wuehr1999/JECCbotMower/hardware/controlpcb/rendering.png

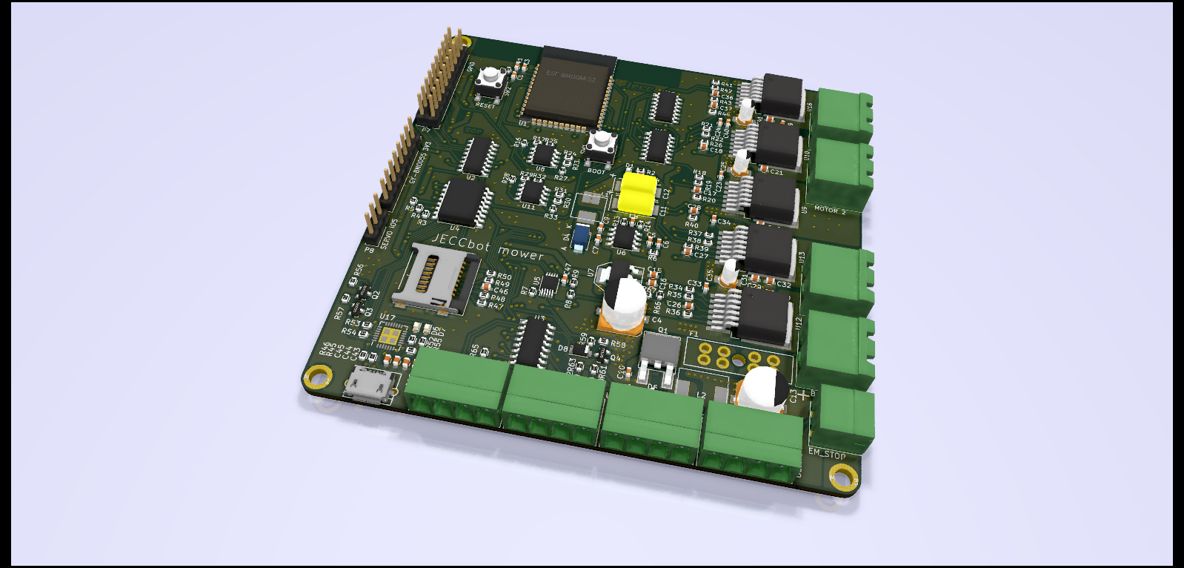
hardware/controlpcb/rendering.png
