wuehr1999/JECCbotMower/README.md

# JECCbotMower

Implementation of JECCbot modifications for lawn mowing robot
