wuehr1999/JECCbotMower/hardware/controlpcb/kicad-source/JECCbotESP32.kicad_pcb

## KiCad design hardware/controlpcb/kicad-source/JECCbotESP32.kicad_pcb (2020-06-06)

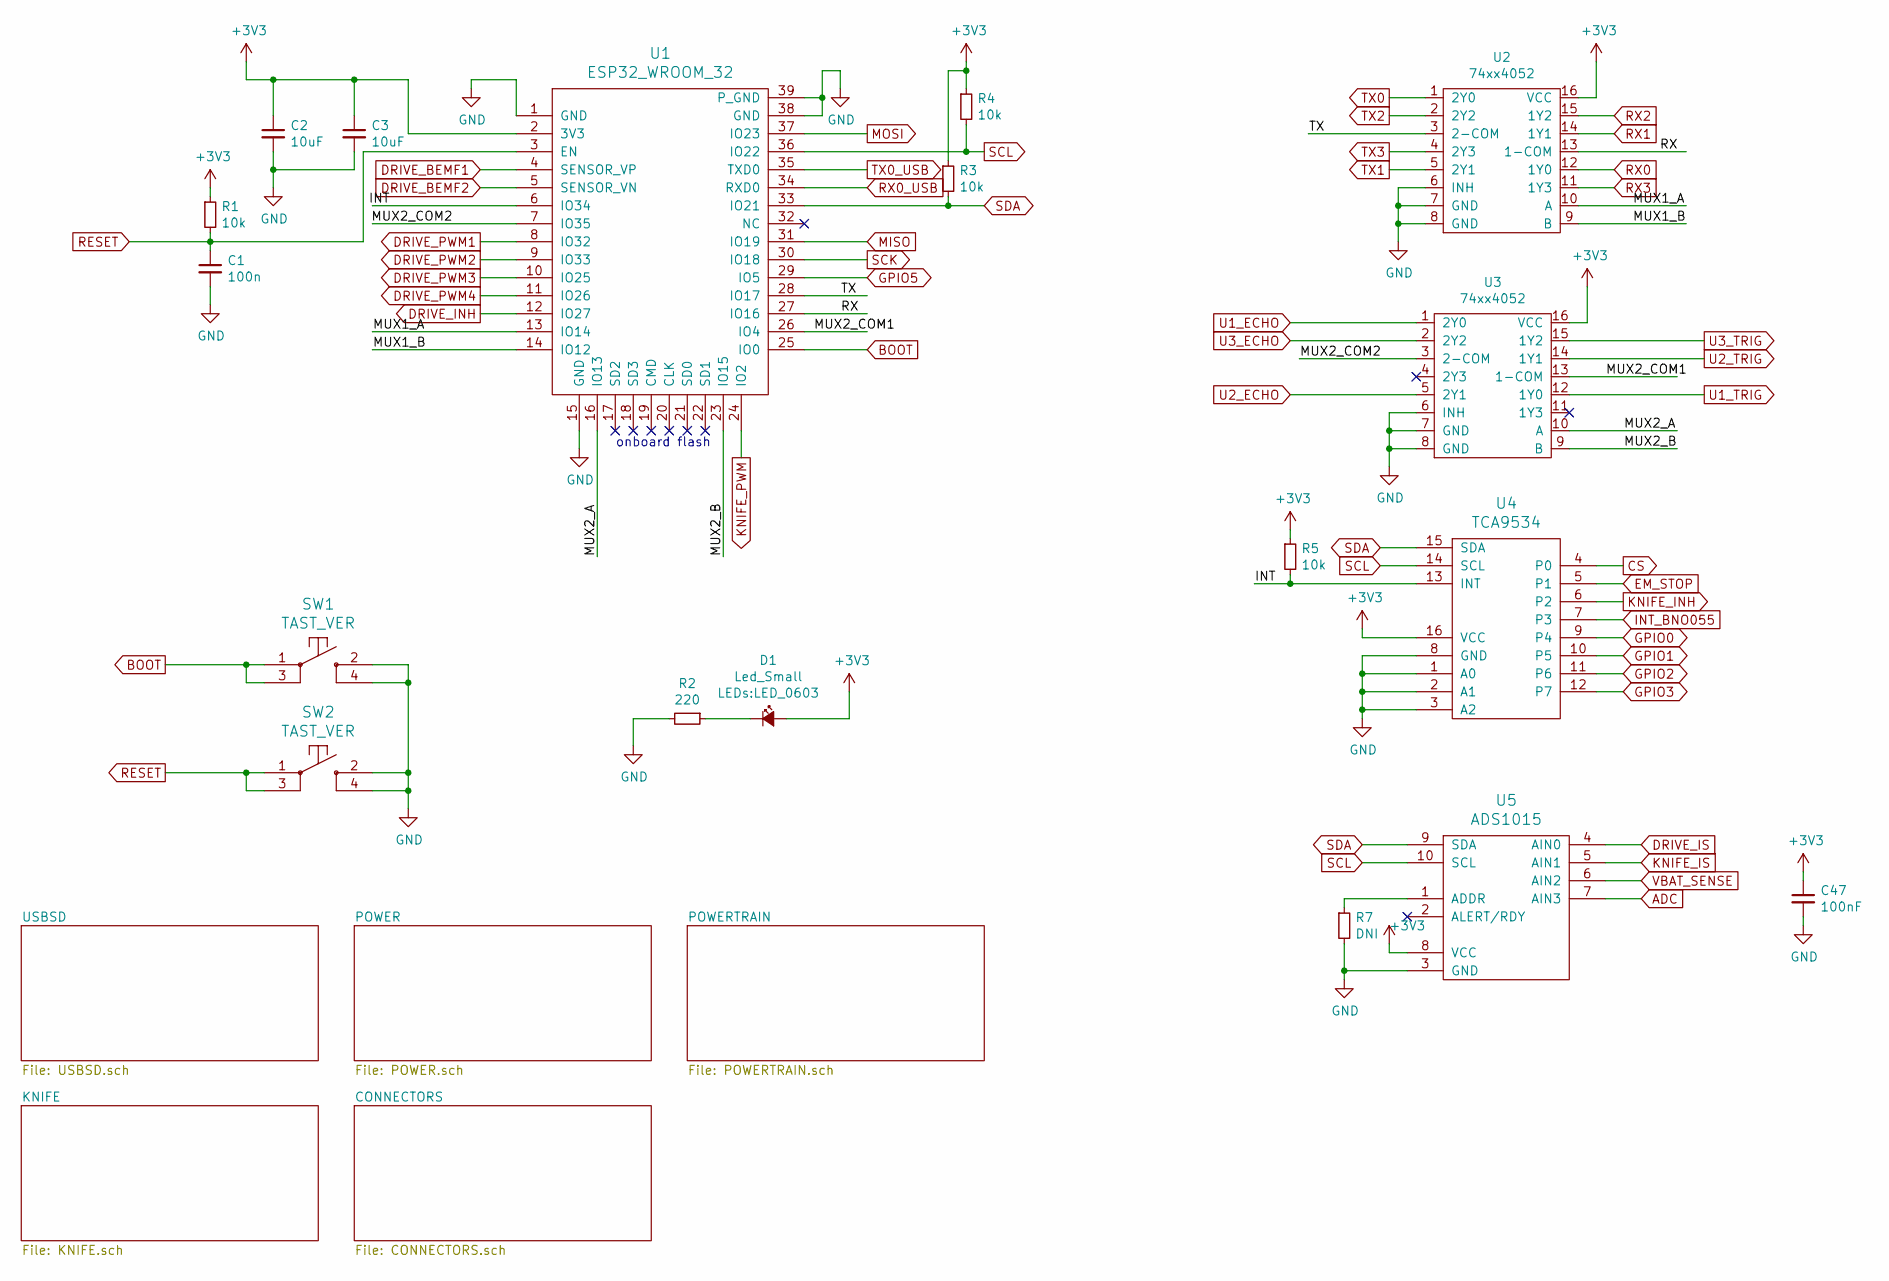
[picture p8: schematic JECCbotESP32.sch, JECCbot Mower PCB ESP32]

Parts:
C1: 100n; C_0603
C2, C3: 10uF; C_0603
C47: 100nF; C_0603
D1: Led_Small; LED_0603
R1, R3, R4, R5: 10k; R_0603
R2: 220; R_0603
R7: DNI; R_0603
SW1, SW2: TAST_VER; WE_430182050816
U1: ESP32_WROOM_32; ESP32-WROOM-32
U2, U3: 74xx4052; SOIC-16_3.9x9.9mm_Pitch1.27mm
U4: TCA9534; SOIC-16_7.5x10.3mm_Pitch1.27mm
U5: ADS1015; MSOP-10_3x3mm_Pitch0.5mm

Connections:
+3V3: C2.1, C3.1, C47.1, D1.2 (A), R1.1, R3.1, R4.1, R5.1, U1.2 (3V3), U2.16 (VCC), U3.16 (VCC), U4.16 (VCC), U5.8 (VCC); also elsewhere on the board
/INT: R5.2, U1.6 (IO34), U4.13 (INT)
/MUX1_A: U1.13 (IO14), U2.10 (A)
/MUX1_B: U1.14 (IO12), U2.9 (B)
/MUX2_A: U1.16 (IO13), U3.10 (A)
/MUX2_B: U1.23 (IO15), U3.9 (B)
/MUX2_COM1: U1.26 (IO4), U3.13 (1-COM)
/MUX2_COM2: U1.7 (IO35), U3.3 (2-COM)
/RX: U1.27 (IO16), U2.13 (1-COM)
/TX: U1.28 (IO17), U2.3 (2-COM)
ADC: U5.7 (AIN3); also elsewhere on the board
BOOT: SW1.1, SW1.3, U1.25 (IO0); also elsewhere on the board
CS: U4.4 (P0); also elsewhere on the board
DRIVE_BEMF1: U1.4 (SENSOR_VP); also elsewhere on the board
DRIVE_BEMF2: U1.5 (SENSOR_VN); also elsewhere on the board
DRIVE_INH: U1.12 (IO27); also elsewhere on the board
DRIVE_IS: U5.4 (AIN0); also elsewhere on the board
DRIVE_PWM1: U1.8 (IO32); also elsewhere on the board
DRIVE_PWM2: U1.9 (IO33); also elsewhere on the board
DRIVE_PWM3: U1.10 (IO25); also elsewhere on the board
DRIVE_PWM4: U1.11 (IO26); also elsewhere on the board
EM_STOP: U4.5 (P1); also elsewhere on the board
GND: C1.2, C2.2, C3.2, C47.2, R2.2, R7.2, SW1.2, SW1.4, SW2.2, SW2.4, U1.1 (GND), U1.15 (GND), U1.38 (GND), U1.39 (P_GND), U2.6 (INH), U2.7 (GND), U2.8 (GND), U3.6 (INH), U3.7 (GND), U3.8 (GND), U4.1 (A0), U4.2 (A1), U4.3 (A2), U4.8 (GND), U5.3 (GND); also elsewhere on the board
GPIO0: U4.9 (P4); also elsewhere on the board
GPIO1: U4.10 (P5); also elsewhere on the board
GPIO2: U4.11 (P6); also elsewhere on the board
GPIO3: U4.12 (P7); also elsewhere on the board
GPIO5: U1.29 (IO5); also elsewhere on the board
INT_BNO055: U4.7 (P3); also elsewhere on the board
KNIFE_INH: U4.6 (P2); also elsewhere on the board
KNIFE_IS: U5.5 (AIN1); also elsewhere on the board
KNIFE_PWM: U1.24 (IO2); also elsewhere on the board
MISO: U1.31 (IO19); also elsewhere on the board
MOSI: U1.37 (IO23); also elsewhere on the board
unnamed: D1.1 (K), R2.1
unnamed: R7.1, U5.1 (ADDR)
RESET: C1.1, R1.2, SW2.1, SW2.3, U1.3 (EN); also elsewhere on the board
RX0: U2.12 (1Y0); also elsewhere on the board
RX0_USB: U1.34 (RXD0); also elsewhere on the board
RX1: U2.14 (1Y1); also elsewhere on the board
RX2: U2.15 (1Y2); also elsewhere on the board
RX3: U2.11 (1Y3); also elsewhere on the board
SCK: U1.30 (IO18); also elsewhere on the board
SCL: R4.2, U1.36 (IO22), U4.14 (SCL), U5.10 (SCL); also elsewhere on the board
SDA: R3.2, U1.33 (IO21), U4.15 (SDA), U5.9 (SDA); also elsewhere on the board
TX0: U2.1 (2Y0); also elsewhere on the board
TX0_USB: U1.35 (TXD0); also elsewhere on the board
TX1: U2.5 (2Y1); also elsewhere on the board
TX2: U2.2 (2Y2); also elsewhere on the board
TX3: U2.4 (2Y3); also elsewhere on the board
U1_ECHO: U3.1 (2Y0); also elsewhere on the board
U1_TRIG: U3.12 (1Y0); also elsewhere on the board
U2_ECHO: U3.5 (2Y1); also elsewhere on the board
U2_TRIG: U3.14 (1Y1); also elsewhere on the board
U3_ECHO: U3.2 (2Y2); also elsewhere on the board
U3_TRIG: U3.15 (1Y2); also elsewhere on the board
VBAT_SENSE: U5.6 (AIN2); also elsewhere on the board

Notes on the sheet:
onboard flash

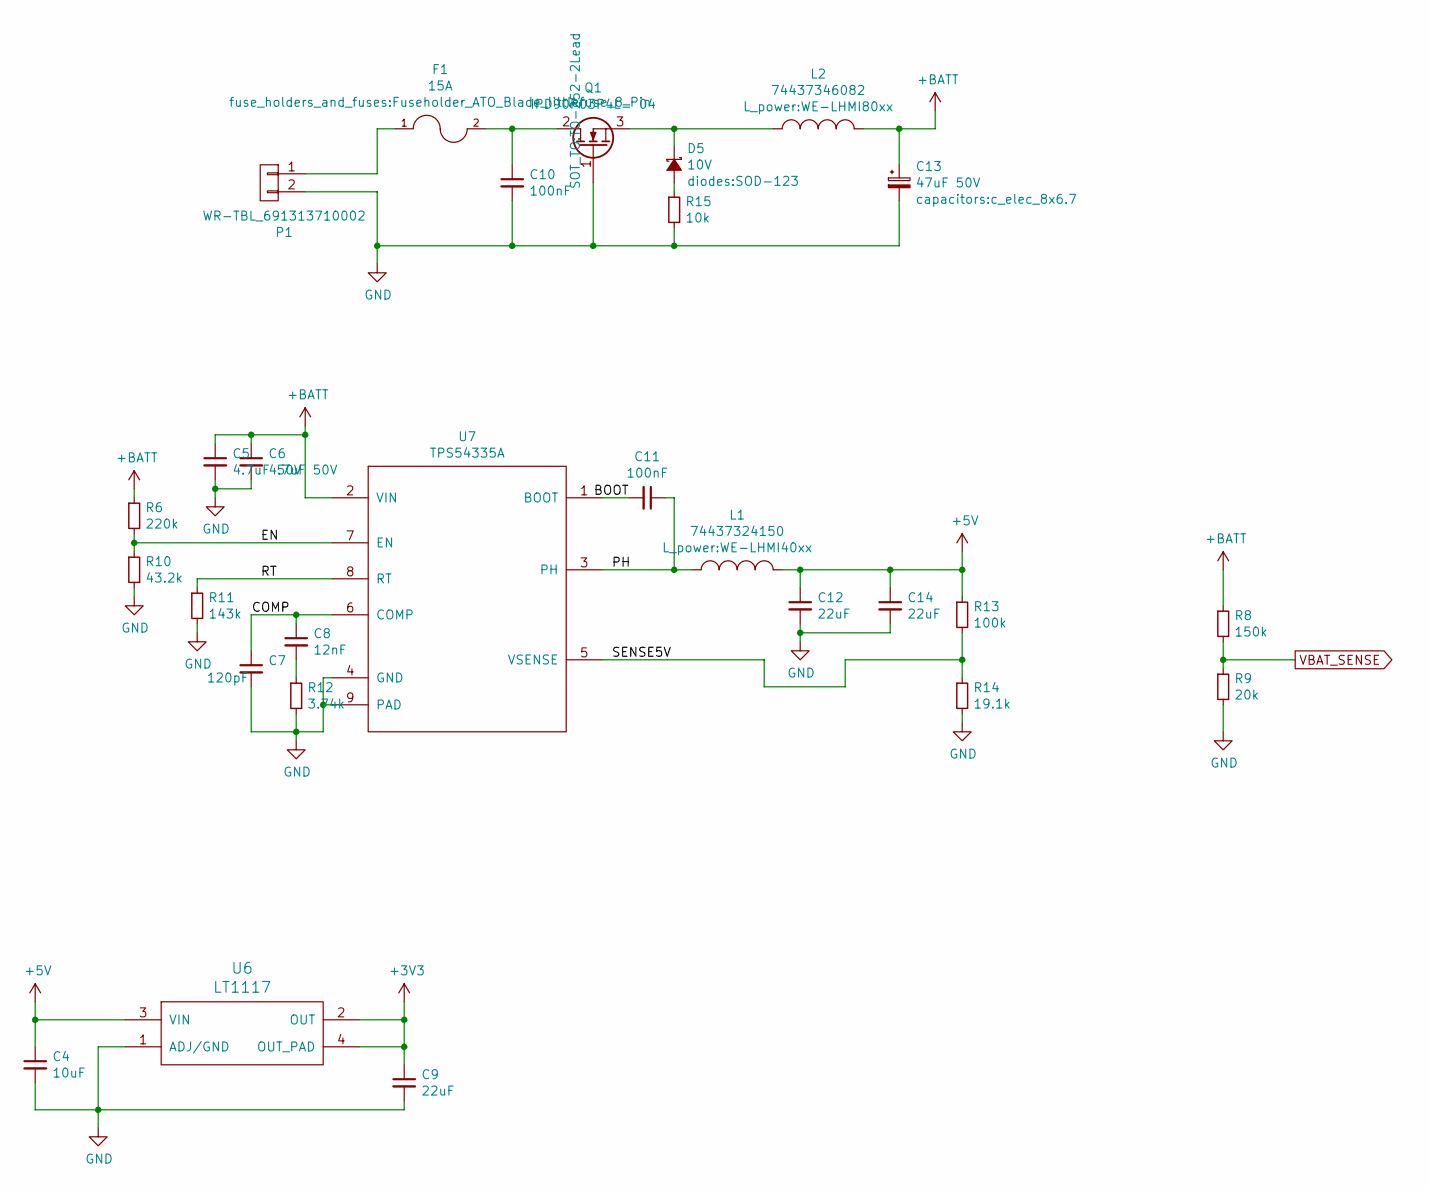
[picture p9: schematic POWER.sch, JECCbot Mower PCB ESP32]

Parts:
C4: 10uF; C_1206
C5, C6: 4.7uF 50V; C_1206
C7: 120pF; C_0603
C8: 12nF; C_0603
C9, C12, C14: 22uF; C_1206
C10, C11: 100nF; C_0603
C13: 47uF 50V; c_elec_8x6.7
D5: 10V; SOD-123
F1: 15A; Fuseholder_ATO_Blade_littlefuse_8_Pin
L1: 74437324150; WE-LHMI40xx
L2: 74437346082; WE-LHMI80xx
P1: WR-TBL_691313710002
Q1: IPD90P03P4L- 04; TO-252-2Lead
R6: 220k; R_0603
R8: 150k; R_0603
R9: 20k; R_0603
R10: 43.2k; R_0603
R11: 143k; R_0603
R12: 3.74k; R_0603
R13: 100k; R_0603
R14: 19.1k; R_0603
R15: 10k; R_0603
U6: LT1117; SOT-223
U7: TPS54335A; SOIC-8-1EP_3.9x4.9mm_Pitch1.27mm

Connections:
+3V3: C9.1, U6.2 (OUT), U6.4 (OUT_PAD); also elsewhere on the board
+5V: C4.1, C12.1, C14.1, L1.2, R13.1, U6.3 (VIN); also elsewhere on the board
+BATT: C5.1, C6.1, C13.1, L2.2, R6.1, R8.1, U7.2 (VIN); also elsewhere on the board
/POWER/COMP: C7.1, C8.1, U7.6 (COMP)
/POWER/EN: R6.2, R10.1, U7.7 (EN)
/POWER/PH: C11.1, L1.1, U7.3 (PH)
/POWER/RT: R11.1, U7.8 (RT)
/POWER/SENSE5V: R13.2, R14.1, U7.5 (VSENSE)
GND: C4.2, C5.2, C6.2, C7.2, C9.2, C10.2, C12.2, C13.2, C14.2, P1.2, Q1.1 (G), R9.2, R10.2, R11.2, R12.2, R14.2, R15.2, U6.1 (ADJ/GND), U7.4 (GND), U7.9 (PAD); also elsewhere on the board
unnamed: C8.2, R12.1
unnamed: C10.1, F1.2, Q1.2 (D)
unnamed: C11.2, U7.1 (BOOT)
unnamed: D5.1 (K), L2.1, Q1.3 (S)
unnamed: D5.2 (A), R15.1
unnamed: F1.1, P1.1
VBAT_SENSE: R8.2, R9.1; also elsewhere on the board

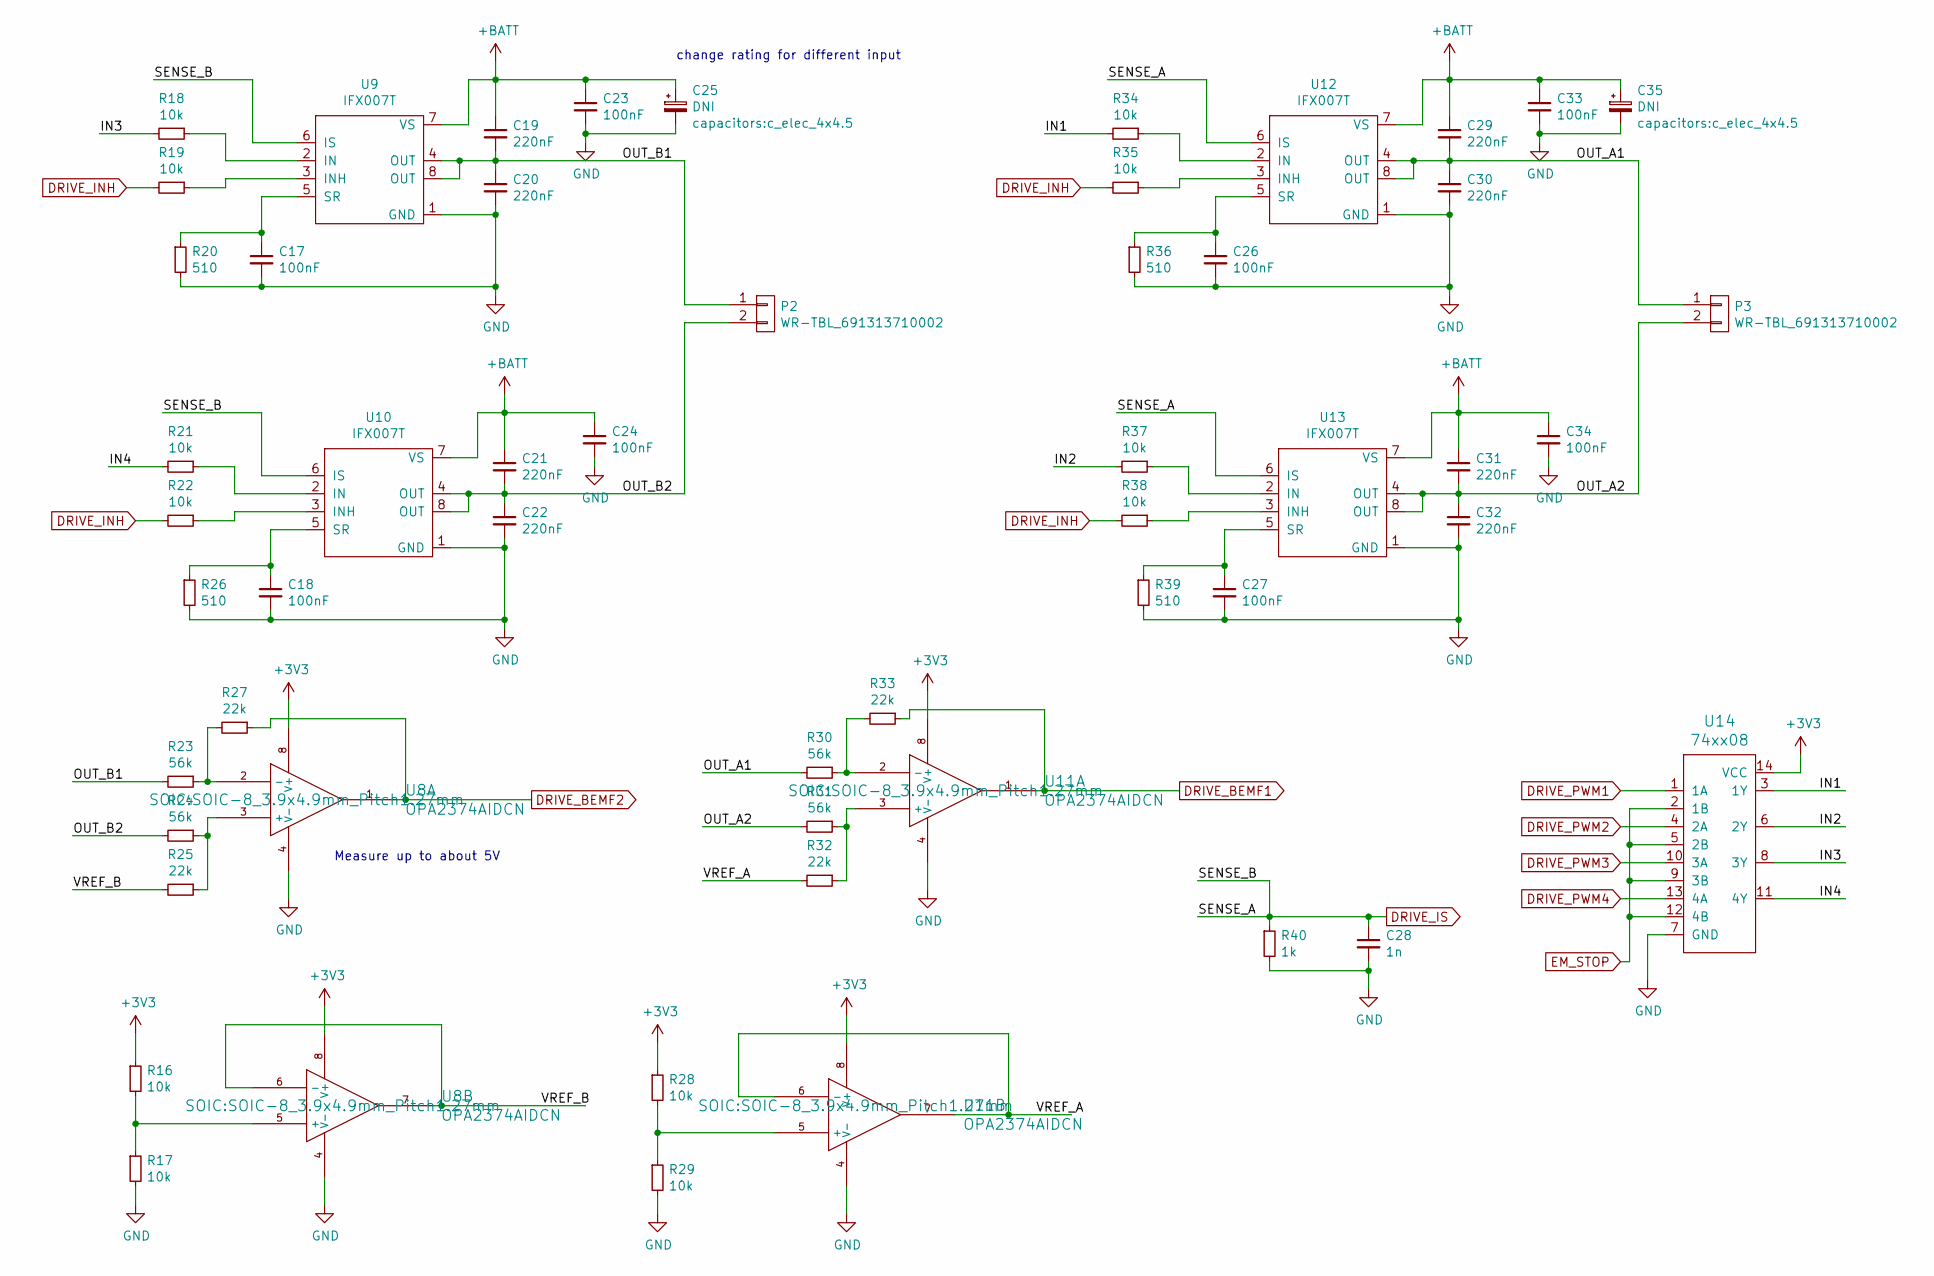
[picture p10: schematic POWERTRAIN.sch, JECCbot Mower PCB ESP32]

Parts:
C17, C18, C23, C24, C26, C27, C33, C34: 100nF; C_0603
C19, C20, C21, C22, C29, C30, C31, C32: 220nF; C_0603
C25, C35: DNI; c_elec_4x4.5
C28: 1n; C_0603
P2, P3: WR-TBL_691313710002
R16, R17, R18, R19, R21, R22, R28, R29, R34, R35, R37, R38: 10k; R_0603
R20, R26, R36, R39: 510; R_0603
R23, R24, R30, R31: 56k; R_0603
R25, R27, R32, R33: 22k; R_0603
R40: 1k; R_0603
U8, U11: OPA2374AIDCN; SOIC-8_3.9x4.9mm_Pitch1.27mm
U9, U10, U12, U13: IFX007T; TO-263-7Lead
U14: 74xx08; SOIC-14_3.9x8.7mm_Pitch1.27mm

Connections:
+3V3: R16.1, R28.1, U8.8 (V+), U11.8 (V+), U14.14 (VCC); also elsewhere on the board
+BATT: C19.1, C21.1, C23.1, C24.1, C25.1, C29.1, C31.1, C33.1, C34.1, C35.1, U9.7 (VS), U10.7 (VS), U12.7 (VS), U13.7 (VS); also elsewhere on the board
/POWERTRAIN/IN1: R34.2, U14.3 (1Y)
/POWERTRAIN/IN2: R37.2, U14.6 (2Y)
/POWERTRAIN/IN3: R18.2, U14.8 (3Y)
/POWERTRAIN/IN4: R21.2, U14.11 (4Y)
/POWERTRAIN/OUT_A1: C29.2, C30.1, P3.1, R30.2, U12.4 (OUT), U12.8 (OUT)
/POWERTRAIN/OUT_A2: C31.2, C32.1, P3.2, R31.2, U13.4 (OUT), U13.8 (OUT)
/POWERTRAIN/OUT_B1: C19.2, C20.1, P2.1, R23.2, U9.4 (OUT), U9.8 (OUT)
/POWERTRAIN/OUT_B2: C21.2, C22.1, P2.2, R24.2, U10.4 (OUT), U10.8 (OUT)
/POWERTRAIN/VREF_A: R32.2, U11.6 (-), U11.7
/POWERTRAIN/VREF_B: R25.2, U8.6 (-), U8.7
DRIVE_BEMF1: R33.1, U11.1; also elsewhere on the board
DRIVE_BEMF2: R27.1, U8.1; also elsewhere on the board
DRIVE_INH: R19.2, R22.2, R35.2, R38.2; also elsewhere on the board
DRIVE_IS: C28.1, R40.1, U9.6 (IS), U10.6 (IS), U12.6 (IS), U13.6 (IS); also elsewhere on the board
DRIVE_PWM1: U14.1 (1A); also elsewhere on the board
DRIVE_PWM2: U14.4 (2A); also elsewhere on the board
DRIVE_PWM3: U14.10 (3A); also elsewhere on the board
DRIVE_PWM4: U14.13 (4A); also elsewhere on the board
EM_STOP: U14.2 (1B), U14.5 (2B), U14.9 (3B), U14.12 (4B); also elsewhere on the board
GND: C17.2, C18.2, C20.2, C22.2, C23.2, C24.2, C25.2, C26.2, C27.2, C28.2, C30.2, C32.2, C33.2, C34.2, C35.2, R17.2, R20.2, R26.2, R29.2, R36.2, R39.2, R40.2, U8.4 (V-), U9.1 (GND), U10.1 (GND), U11.4 (V-), U12.1 (GND), U13.1 (GND), U14.7 (GND); also elsewhere on the board
unnamed: C17.1, R20.1, U9.5 (SR)
unnamed: C18.1, R26.1, U10.5 (SR)
unnamed: C26.1, R36.1, U12.5 (SR)
unnamed: C27.1, R39.1, U13.5 (SR)
unnamed: R16.2, R17.1, U8.5 (+)
unnamed: R18.1, U9.2 (IN)
unnamed: R19.1, U9.3 (INH)
unnamed: R21.1, U10.2 (IN)
unnamed: R22.1, U10.3 (INH)
unnamed: R23.1, R27.2, U8.2 (-)
unnamed: R24.1, R25.1, U8.3 (+)
unnamed: R28.2, R29.1, U11.5 (+)
unnamed: R30.1, R33.2, U11.2 (-)
unnamed: R31.1, R32.1, U11.3 (+)
unnamed: R34.1, U12.2 (IN)
unnamed: R35.1, U12.3 (INH)
unnamed: R37.1, U13.2 (IN)
unnamed: R38.1, U13.3 (INH)

Notes on the sheet:
Measure up to about 5V
change rating for different input

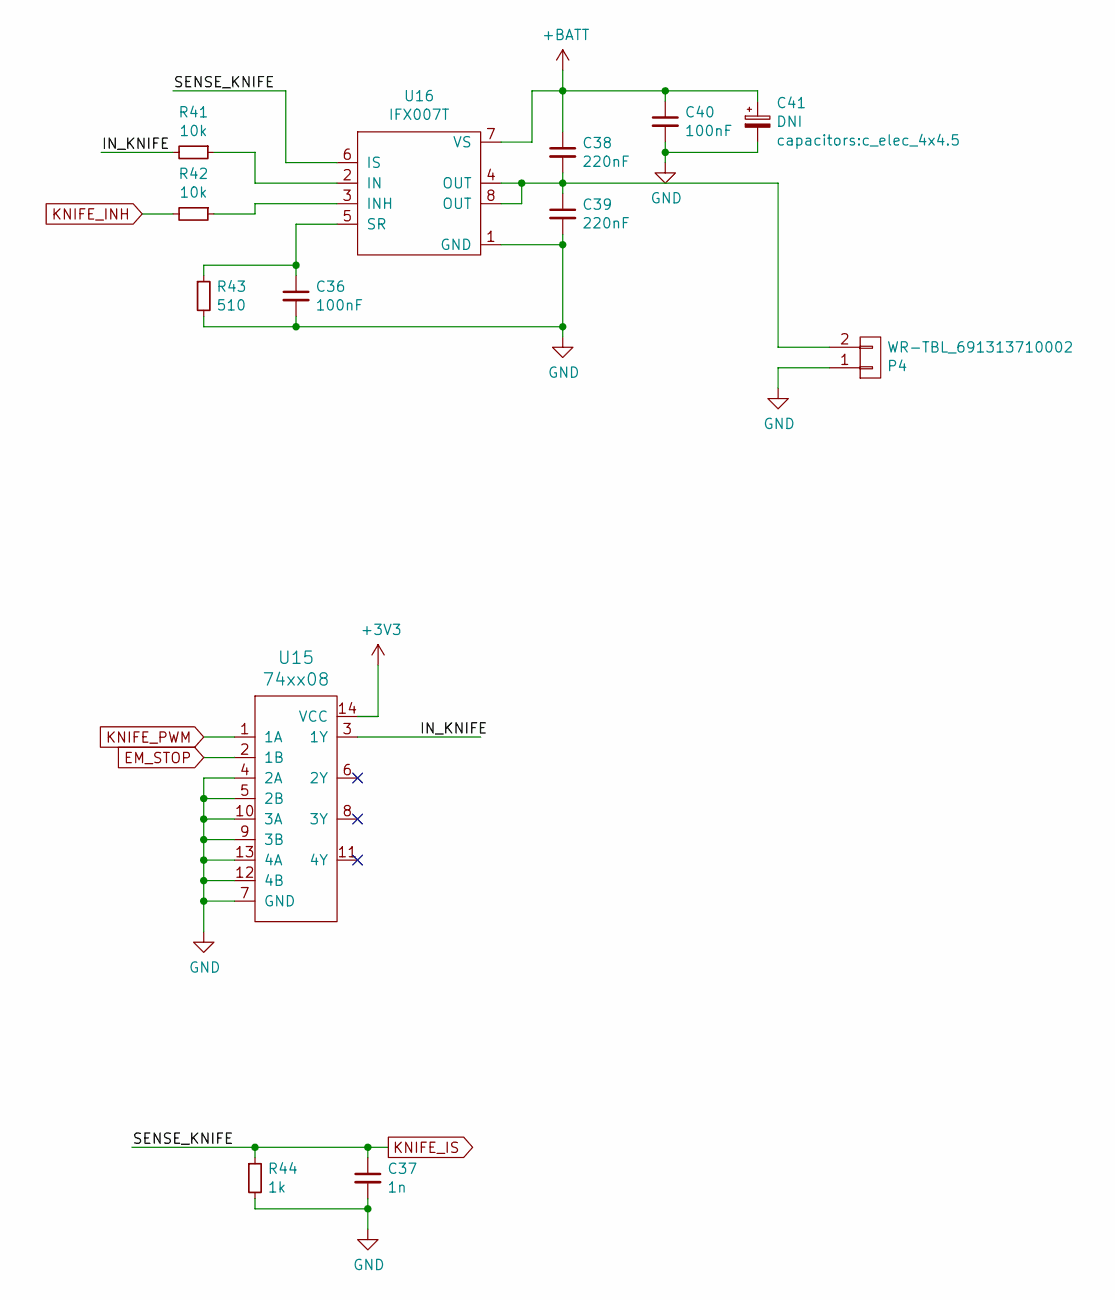
[picture p11: schematic KNIFE.sch, JECCbot Mower PCB ESP32]

Parts:
C36, C40: 100nF; C_0603
C37: 1n; C_0603
C38, C39: 220nF; C_0603
C41: DNI; c_elec_4x4.5
P4: WR-TBL_691313710002
R41, R42: 10k; R_0603
R43: 510; R_0603
R44: 1k; R_0603
U15: 74xx08; SOIC-14_3.9x8.7mm_Pitch1.27mm
U16: IFX007T; TO-263-7Lead

Connections:
+3V3: U15.14 (VCC); also elsewhere on the board
+BATT: C38.1, C40.1, C41.1, U16.7 (VS); also elsewhere on the board
/KNIFE/IN_KNIFE: R41.2, U15.3 (1Y)
EM_STOP: U15.2 (1B); also elsewhere on the board
GND: C36.2, C37.2, C39.2, C40.2, C41.2, P4.1, R43.2, R44.2, U15.4 (2A), U15.5 (2B), U15.7 (GND), U15.9 (3B), U15.10 (3A), U15.12 (4B), U15.13 (4A), U16.1 (GND); also elsewhere on the board
KNIFE_INH: R42.2; also elsewhere on the board
KNIFE_IS: C37.1, R44.1, U16.6 (IS); also elsewhere on the board
KNIFE_PWM: U15.1 (1A); also elsewhere on the board
unnamed: C36.1, R43.1, U16.5 (SR)
unnamed: C38.2, C39.1, P4.2, U16.4 (OUT), U16.8 (OUT)
unnamed: R41.1, U16.2 (IN)
unnamed: R42.1, U16.3 (INH)

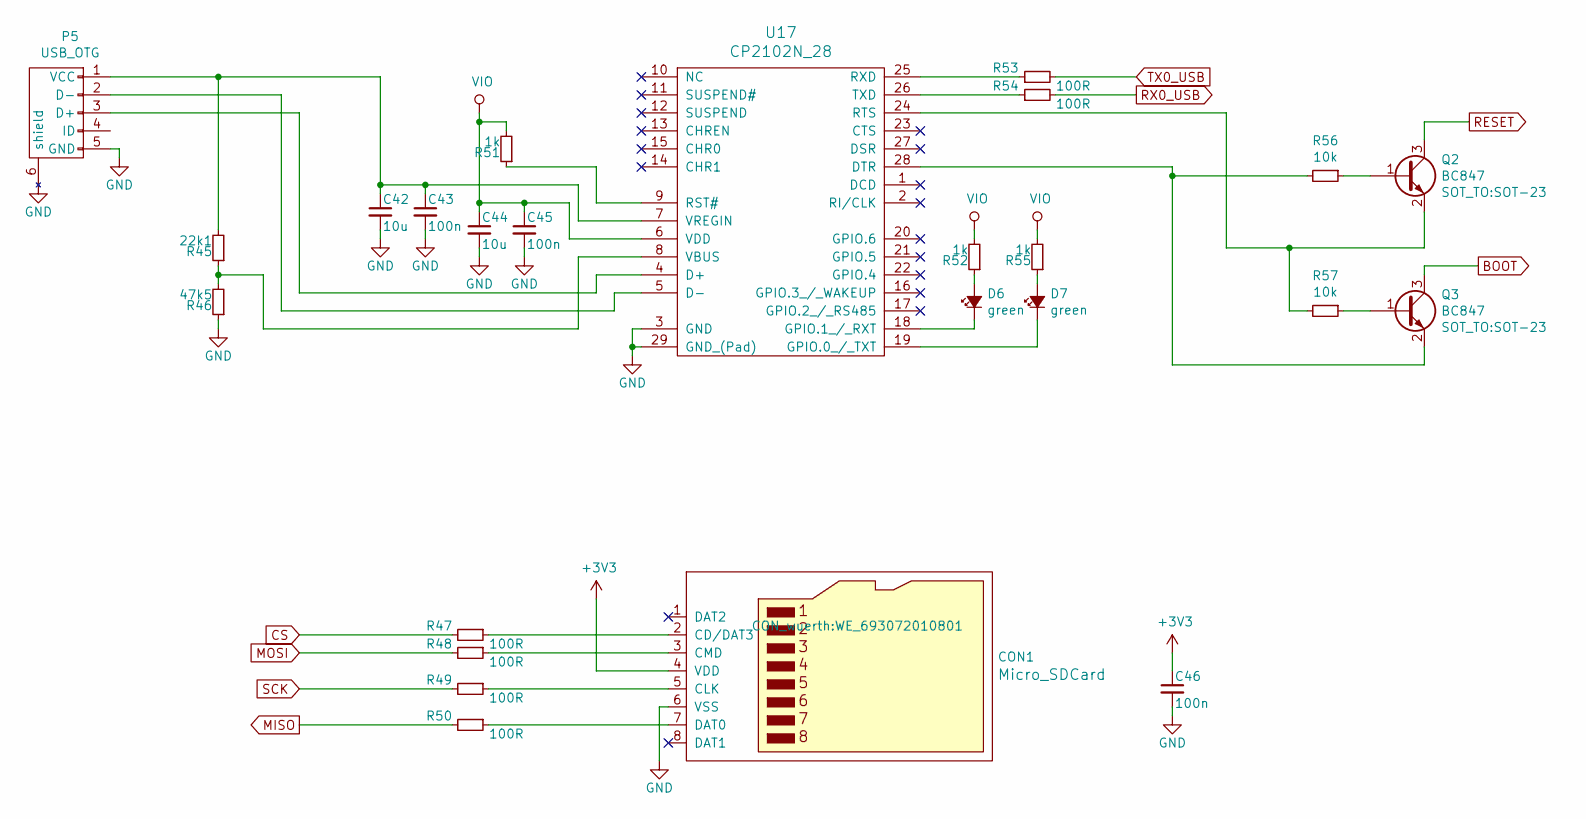
[picture p12: schematic USBSD.sch, JECCbot Mower PCB ESP32]

Parts:
C42, C44: 10u; C_0603
C43, C45, C46: 100n; C_0603
CON1: Micro_SDCard; WE_693072010801
D6, D7: green; LED_0603
P5: USB_OTG; USB_Micro-B
Q2, Q3: BC847; SOT-23
R45: 22k1; R_0603
R46: 47k5; R_0603
R47, R48, R49, R50, R53, R54: 100R; R_0603
R51, R52, R55: 1k; R_0603
R56, R57: 10k; R_0603
U17: CP2102N_28; QFN-28-1EP_5x5mm_Pitch0.5mm

Connections:
+3V3: C46.1, CON1.4 (VDD); also elsewhere on the board
BOOT: Q3.3 (C); also elsewhere on the board
CS: R47.2; also elsewhere on the board
GND: C42.2, C43.2, C44.2, C45.2, C46.2, CON1.6 (VSS), P5.5 (GND), P5.6 (shield), R46.1, U17.3 (GND), U17.29 (GND_(Pad)); also elsewhere on the board
MISO: R50.2; also elsewhere on the board
MOSI: R48.2; also elsewhere on the board
unnamed: C42.1, C43.1, P5.1 (VCC), R45.2, U17.7 (VREGIN)
unnamed: CON1.2 (CD/DAT3), R47.1
unnamed: CON1.3 (CMD), R48.1
unnamed: CON1.5 (CLK), R49.1
unnamed: CON1.7 (DAT0), R50.1
unnamed: D6.1 (K), U17.18 (GPIO.1_/_RXT)
unnamed: D6.2 (A), R52.1
unnamed: D7.1 (K), U17.19 (GPIO.0_/_TXT)
unnamed: D7.2 (A), R55.1
unnamed: P5.2 (D-), U17.5 (D-)
unnamed: P5.3 (D+), U17.4 (D+)
unnamed: Q2.1 (B), R56.1
unnamed: Q2.2 (E), R57.2, U17.24 (RTS)
unnamed: Q3.1 (B), R57.1
unnamed: Q3.2 (E), R56.2, U17.28 (DTR)
unnamed: R45.1, R46.2, U17.8 (VBUS)
unnamed: R51.1, U17.9 (RST#)
unnamed: R53.1, U17.25 (RXD)
unnamed: R54.1, U17.26 (TXD)
RESET: Q2.3 (C); also elsewhere on the board
RX0_USB: R54.2; also elsewhere on the board
SCK: R49.2; also elsewhere on the board
TX0_USB: R53.2; also elsewhere on the board
VIO: C44.1, C45.1, R51.2, R52.2, R55.2, U17.6 (VDD)

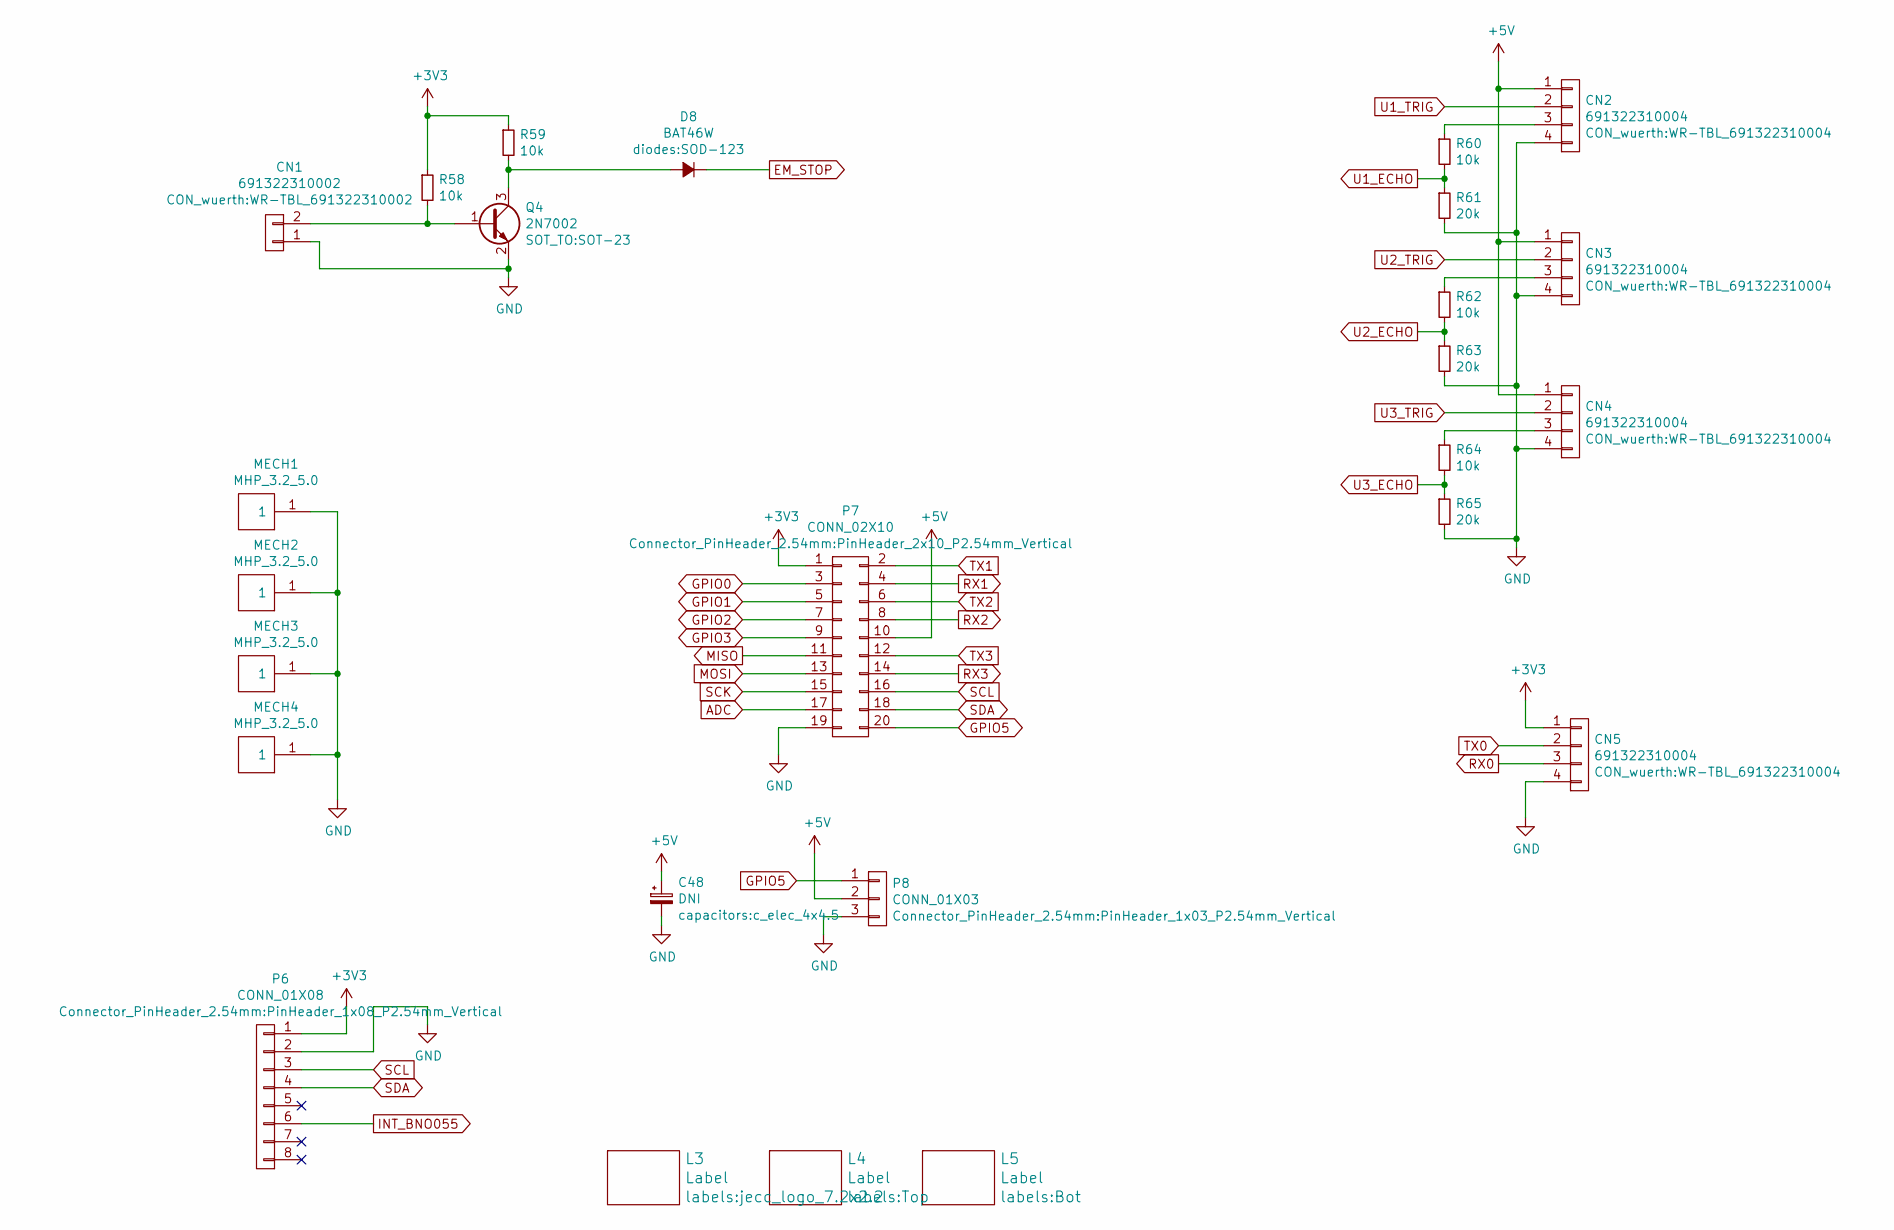
[picture p13: schematic CONNECTORS.sch, JECCbot Mower PCB ESP32]

Parts:
C48: DNI; c_elec_4x4.5
CN1: 691322310002; WR-TBL_691322310002
CN2, CN3, CN4, CN5: 691322310004; WR-TBL_691322310004
D8: BAT46W; SOD-123
L3: Label; jecc_logo_7.2x2.2
L4: Label; Top
L5: Label; Bot
MECH1, MECH2, MECH3, MECH4: MHP_3.2_5.0
P6: CONN_01X08; PinHeader_1x08_P2.54mm_Vertical
P7: CONN_02X10; PinHeader_2x10_P2.54mm_Vertical
P8: CONN_01X03; PinHeader_1x03_P2.54mm_Vertical
Q4: 2N7002; SOT-23
R58, R59, R60, R62, R64: 10k; R_0603
R61, R63, R65: 20k; R_0603

Connections:
+3V3: CN5.1, P6.1, P7.1, R58.1, R59.1; also elsewhere on the board
+5V: C48.1, CN2.1, CN3.1, CN4.1, P7.10, P8.2; also elsewhere on the board
ADC: P7.17; also elsewhere on the board
EM_STOP: D8.1 (K); also elsewhere on the board
GND: C48.2, CN1.1, CN2.4, CN3.4, CN4.4, CN5.4, MECH1.1, MECH2.1, MECH3.1, MECH4.1, P6.2, P7.19, P8.3, Q4.2 (E), R61.2, R63.2, R65.2; also elsewhere on the board
GPIO0: P7.3; also elsewhere on the board
GPIO1: P7.5; also elsewhere on the board
GPIO2: P7.7; also elsewhere on the board
GPIO3: P7.9; also elsewhere on the board
GPIO5: P7.20, P8.1; also elsewhere on the board
INT_BNO055: P6.6; also elsewhere on the board
MISO: P7.11; also elsewhere on the board
MOSI: P7.13; also elsewhere on the board
unnamed: CN1.2, Q4.1 (B), R58.2
unnamed: CN2.3, R60.1
unnamed: CN3.3, R62.1
unnamed: CN4.3, R64.1
unnamed: D8.2 (A), Q4.3 (C), R59.2
RX0: CN5.3; also elsewhere on the board
RX1: P7.4; also elsewhere on the board
RX2: P7.8; also elsewhere on the board
RX3: P7.14; also elsewhere on the board
SCK: P7.15; also elsewhere on the board
SCL: P6.3, P7.16; also elsewhere on the board
SDA: P6.4, P7.18; also elsewhere on the board
TX0: CN5.2; also elsewhere on the board
TX1: P7.2; also elsewhere on the board
TX2: P7.6; also elsewhere on the board
TX3: P7.12; also elsewhere on the board
U1_ECHO: R60.2, R61.1; also elsewhere on the board
U1_TRIG: CN2.2; also elsewhere on the board
U2_ECHO: R62.2, R63.1; also elsewhere on the board
U2_TRIG: CN3.2; also elsewhere on the board
U3_ECHO: R64.2, R65.1; also elsewhere on the board
U3_TRIG: CN4.2; also elsewhere on the board

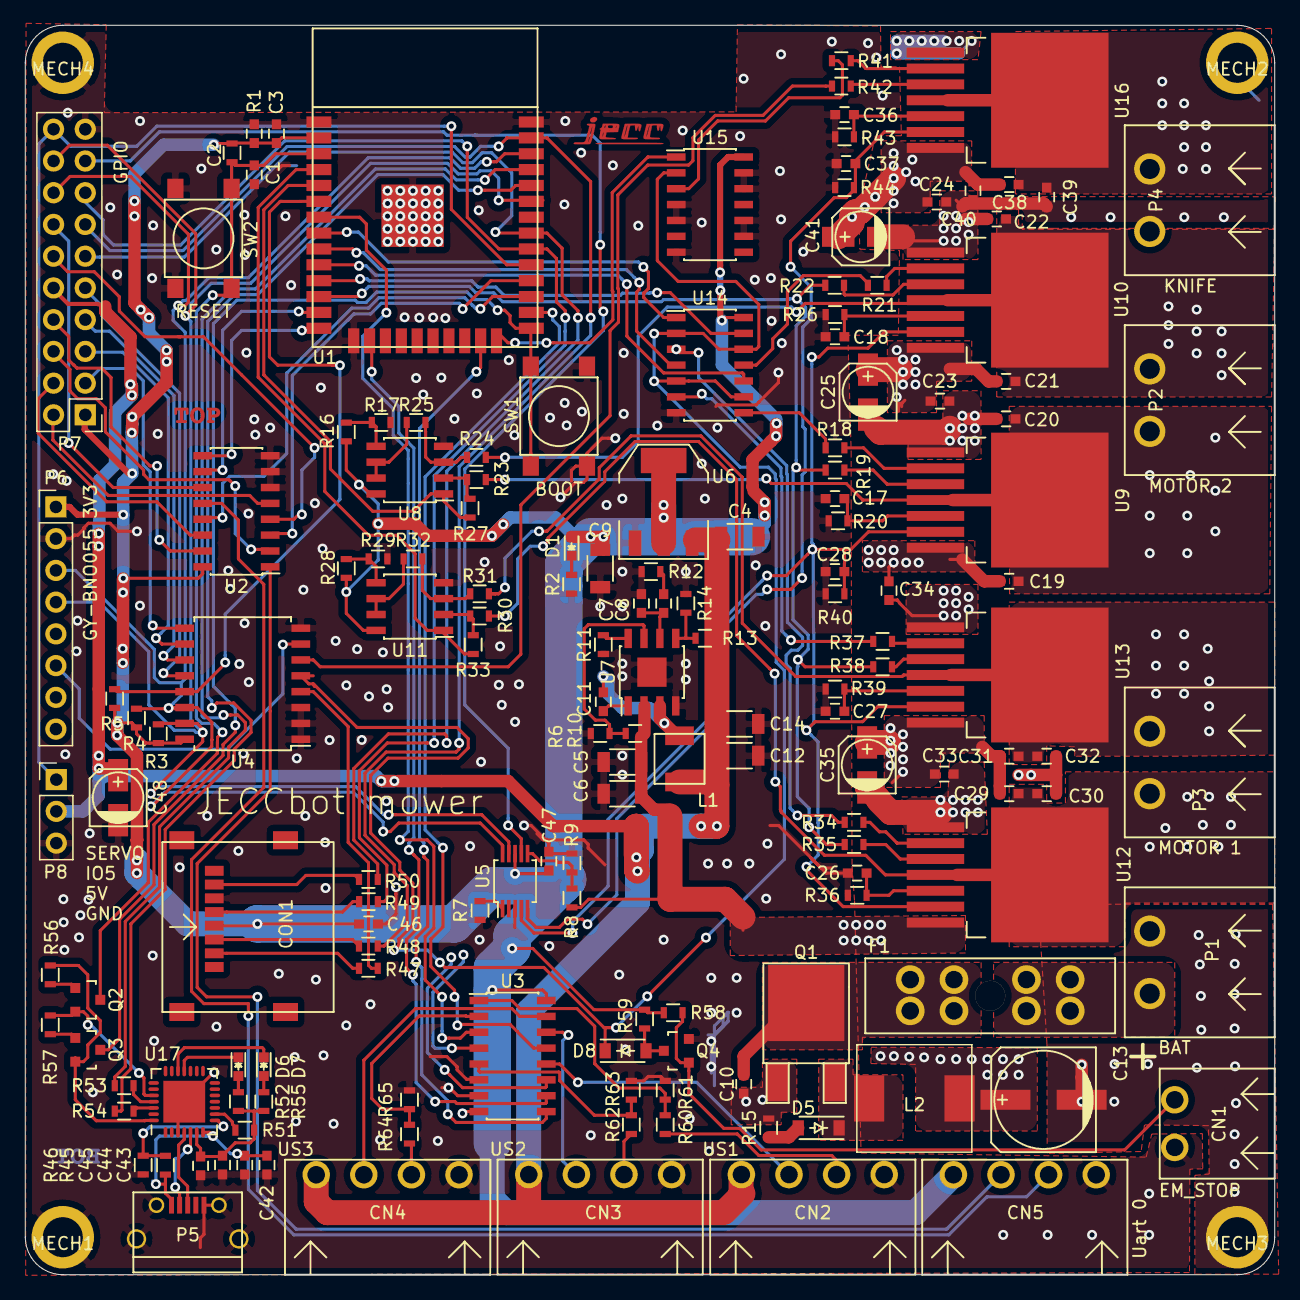
[picture p14: board JECCbotESP32.kicad_pcb from above]

Board: 2 copper layers, 100.0 x 100.0 mm, 163 parts (0 on the bottom side), 128 nets.
