wuehr1999/JECCbotMower/(commit log)

2020-05-28 added kicad source
    [CONNECTORS.sch, JECCbotESP32.kicad_pcb, JECCbotESP32.sch, KNIFE.sch, LOGICALIO.sch, POWER.sch, POWERTRAIN.sch, USBSD.sch]
2020-05-29 added rendering and schematics pdf
    [CONNECTORS.sch, JECCbotESP32.kicad_pcb, JECCbotESP32.sch, KNIFE.sch, POWER.sch, POWERTRAIN.sch, USBSD.sch]
2020-05-30 added servo connector
    [CONNECTORS.sch, JECCbotESP32.kicad_pcb, KNIFE.sch, POWERTRAIN.sch]
2020-06-02 changed layout
    [JECCbotESP32.kicad_pcb]
2020-06-05 changed power supply
    [JECCbotESP32.kicad_pcb, JECCbotESP32.sch, POWER.sch]
2020-06-05 changed ground plane
    [JECCbotESP32.kicad_pcb]
2020-06-06 changed powertrace
    [JECCbotESP32.kicad_pcb]
